HexabitzPlatform/H14R9x-Hardware/README.md

# H14R9x-Hardware
Hexabitz 4 x 5V PWM O/P  + External Supply Module Hardware Design
