HexabitzPlatform/H14R9x-Hardware/Documentation/H14R90.pdf

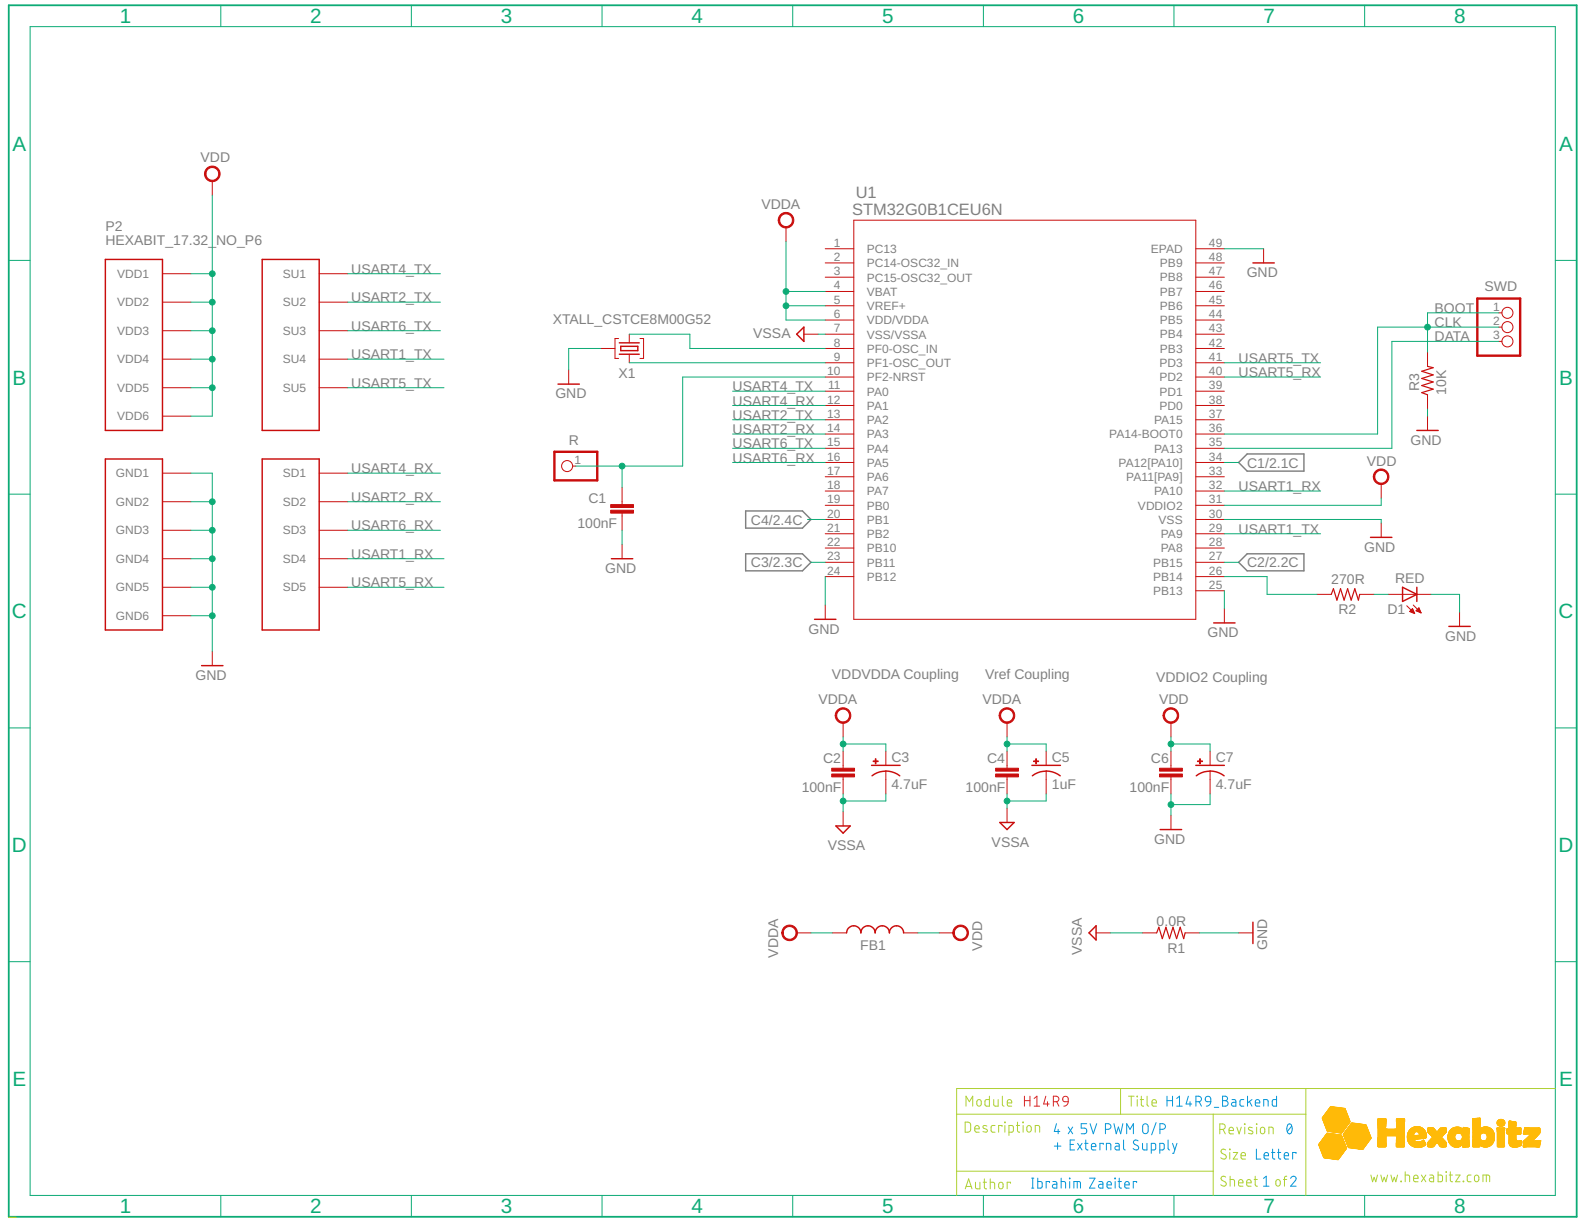
[picture p1: page 1]

5 | 45 PB7
6 | 44 PB6

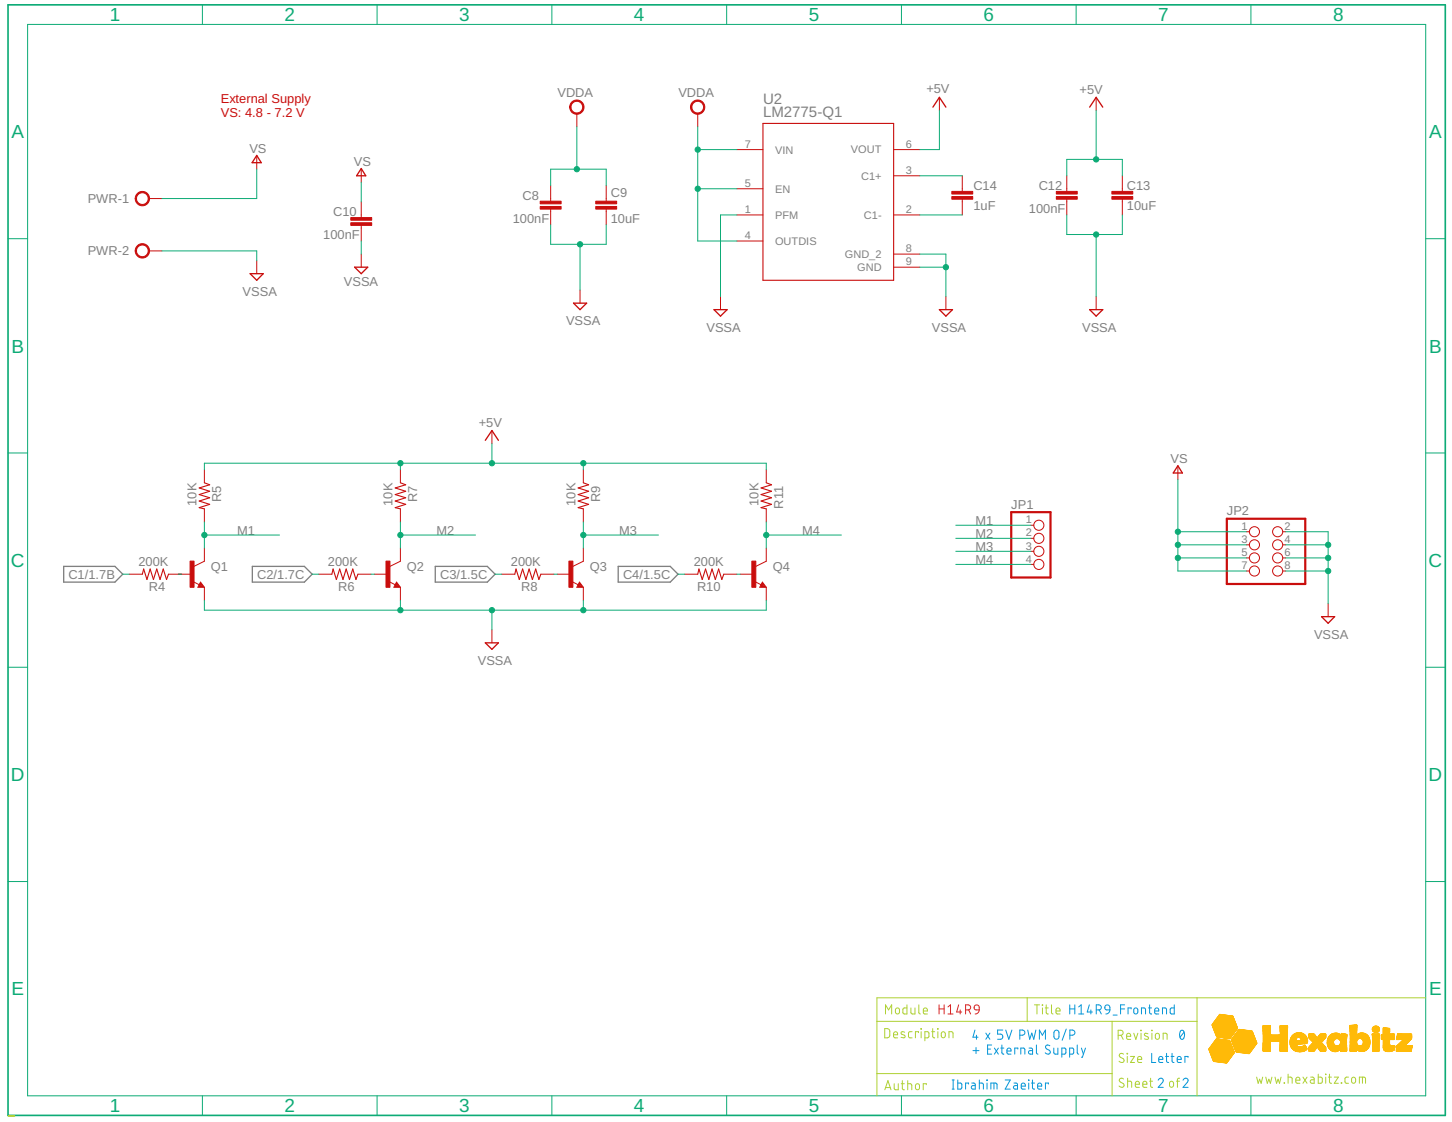
[picture p2: page 2]

3 4
5 6
7 8
