HexabitzPlatform/H14R9x-Hardware/Design/H14R90.brd

## EAGLE design Design/H14R90.brd (2023-11-16)

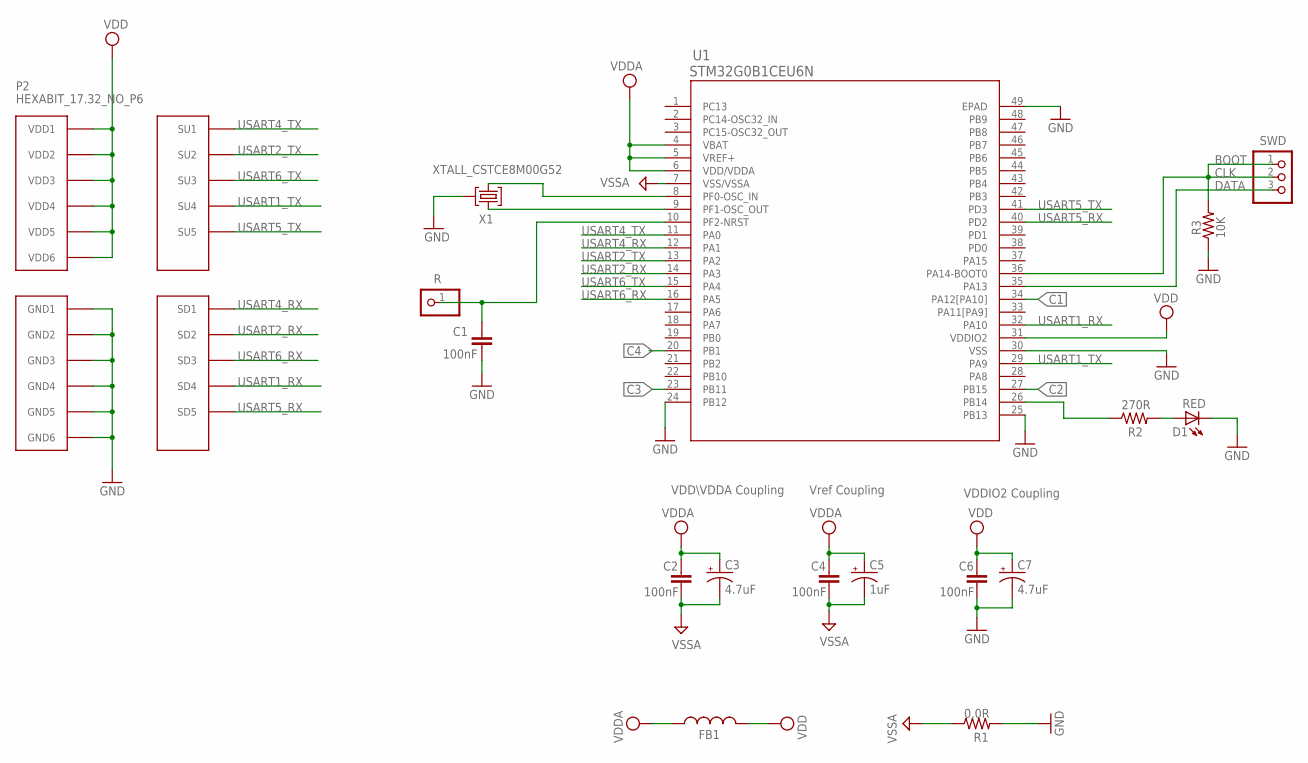
[picture p3: schematic H14R90.sch, sheet 1]

Parts:
C1, C2, C4, C6: 100nF; C-0603
C3, C7: 4.7uF; C-0805-POL
C5: 1uF; C-0805-POL
D1: RED; VLMS1300-GS08; MPN VLMS1300-GS08
FB1: FB-0603
P2: HEXABIT_17.32_NO_P6
R: R; 1X01
R1: 0.0R; R-0603
R2: 270R; R-0603
R3: 10K; R-0603
SWD: PINHD-1X3; 1X03
U1: STM32G0B1CEU6N; HEXABITZ_ICS_QFN_B1CEU6_STM-L
X1: XTALL_CSTCE8M00G52

Connections:
C1: U1.34 (PA12[PA10]); also elsewhere on the board
C2: U1.27 (PB15); also elsewhere on the board
C3: U1.23 (PB11); also elsewhere on the board
C4: U1.20 (PB1); also elsewhere on the board
CLK: R3.2, SWD.1, SWD.2, U1.36 (PA14-BOOT0)
DATA: SWD.3, U1.35 (PA13)
GND: C1.2, C6.2, C7.2 (-), D1.C, P2.PAD_PD7 (GND1), P2.PAD_PD8 (GND2), P2.PAD_PD9 (GND3), P2.PAD_PD10 (GND4), P2.PAD_PD11 (GND5), P2.PAD_PD12 (GND6), R1.2, R3.1, U1.24 (PB12), U1.25 (PB13), U1.30 (VSS), U1.49 (EPAD), X1.P$2 (2)
unnamed: D1.A, R2.2
unnamed: U1.9 (PF1-OSC_OUT), X1.P$1 (1)
unnamed: U1.8 (PF0-OSC_IN), X1.P$3 (3)
unnamed: C1.1, R.1, U1.10 (PF2-NRST)
unnamed: R2.1, U1.26 (PB14)
USART1_RX: P2.PAD_PD4 (SD4), U1.32 (PA10)
USART1_TX: P2.PAD_PU4 (SU4), U1.29 (PA9)
USART2_RX: P2.PAD_PD2 (SD2), U1.14 (PA3)
USART2_TX: P2.PAD_PU2 (SU2), U1.13 (PA2)
USART4_RX: P2.PAD_PD1 (SD1), U1.12 (PA1)
USART4_TX: P2.PAD_PU1 (SU1), U1.11 (PA0)
USART5_RX: P2.PAD_PD5 (SD5), U1.40 (PD2)
USART5_TX: P2.PAD_PU5 (SU5), U1.41 (PD3)
USART6_RX: P2.PAD_PD3 (SD3), U1.16 (PA5)
USART6_TX: P2.PAD_PU3 (SU3), U1.15 (PA4)
VDD: C6.1, C7.1 (+), FB1.2, P2.PAD_PU7 (VDD1), P2.PAD_PU8 (VDD2), P2.PAD_PU9 (VDD3), P2.PAD_PU10 (VDD4), P2.PAD_PU11 (VDD5), P2.PAD_PU12 (VDD6), U1.31 (VDDIO2)
VDDA: C2.1, C3.1 (+), C4.1, C5.1 (+), FB1.1, U1.4 (VBAT), U1.5 (VREF+), U1.6 (VDD/VDDA); also elsewhere on the board
VSSA: C2.2, C3.2 (-), C4.2, C5.2 (-), R1.1, U1.7 (VSS/VSSA); also elsewhere on the board

Notes on the sheet:
Vref Coupling
VDDIO2 Coupling
VDD\VDDA Coupling
BOOT

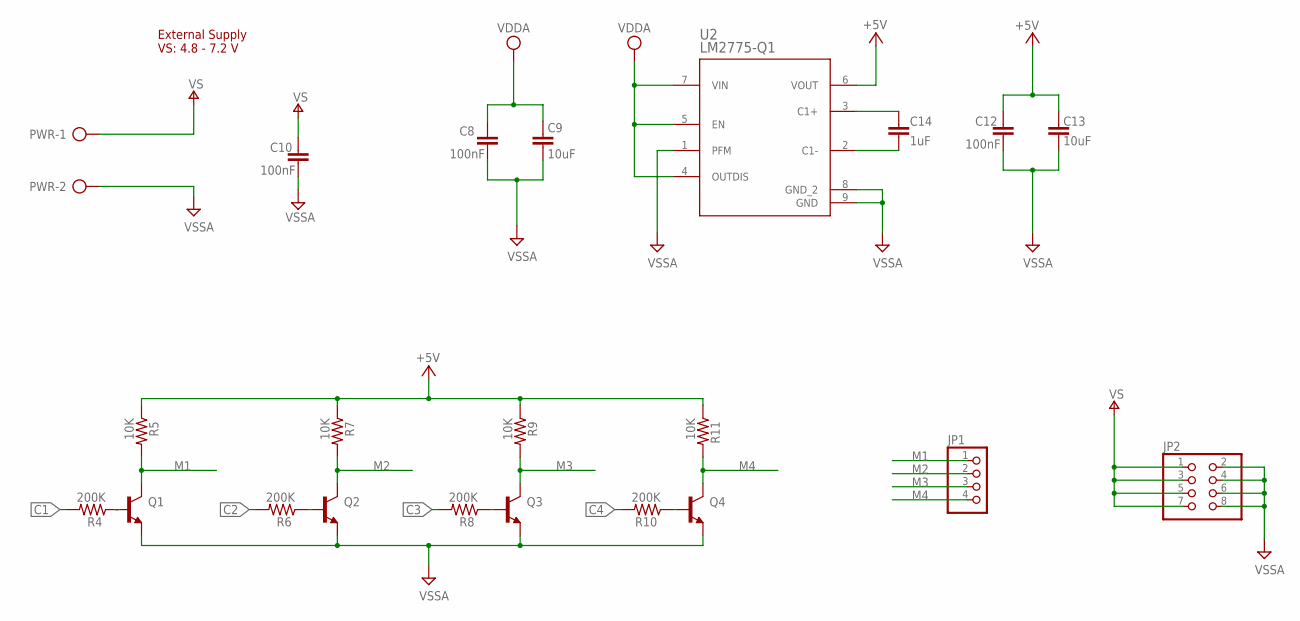
[picture p4: schematic H14R90.sch, sheet 2]

Parts:
C8, C10, C12: 100nF; C-0603
C9, C13: 10uF; C-0603
C14: 1uF; C-0603
JP1: PINHD-1X4; 1X04
JP2: PINHD-2X4; 2X04
PWR: AK500/2
Q1, Q2, Q3, Q4: MMBT3904LT1
R4, R6, R8, R10: 200K; R-0603
R5, R7, R9, R11: 10K; R-0603
U2: LM2775-Q1; DSG0008A

Connections:
+5V: C12.1, C13.1, R5.1, R7.1, R9.1, R11.1, U2.6 (VOUT)
C1: R4.2; also elsewhere on the board
C2: R6.2; also elsewhere on the board
C3: R8.2; also elsewhere on the board
C4: R10.2; also elsewhere on the board
M1: JP1.1, Q1.3 (C), R5.2
M2: JP1.2, Q2.3 (C), R7.2
M3: JP1.3, Q3.3 (C), R9.2
M4: JP1.4, Q4.3 (C), R11.2
unnamed: C14.2, U2.2 (C1-)
unnamed: C14.1, U2.3 (C1+)
unnamed: Q1.1 (B), R4.1
unnamed: Q2.1 (B), R6.1
unnamed: Q3.1 (B), R8.1
unnamed: Q4.1 (B), R10.1
V+: C10.1, JP2.1, JP2.3, JP2.5, JP2.7, PWR.1
VDDA: C8.1, C9.1, U2.4 (OUTDIS), U2.5 (EN), U2.7 (VIN); also elsewhere on the board
VSSA: C8.2, C9.2, C10.2, C12.2, C13.2, JP2.2, JP2.4, JP2.6, JP2.8, PWR.2, Q1.2 (E), Q2.2 (E), Q3.2 (E), Q4.2 (E), U2.1 (PFM), U2.8 (GND_2), U2.9 (GND); also elsewhere on the board

Notes on the sheet:
External Supply VS: 4.8 - 7.2 V

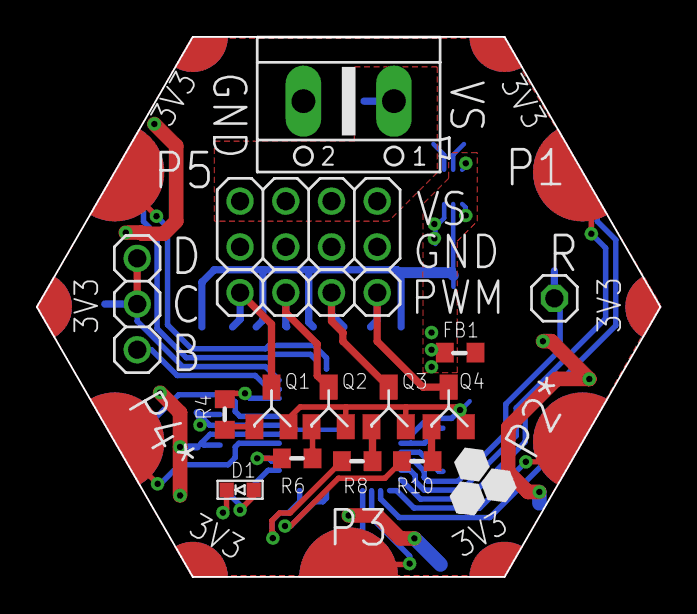
[picture p5: board H14R90.brd from above]

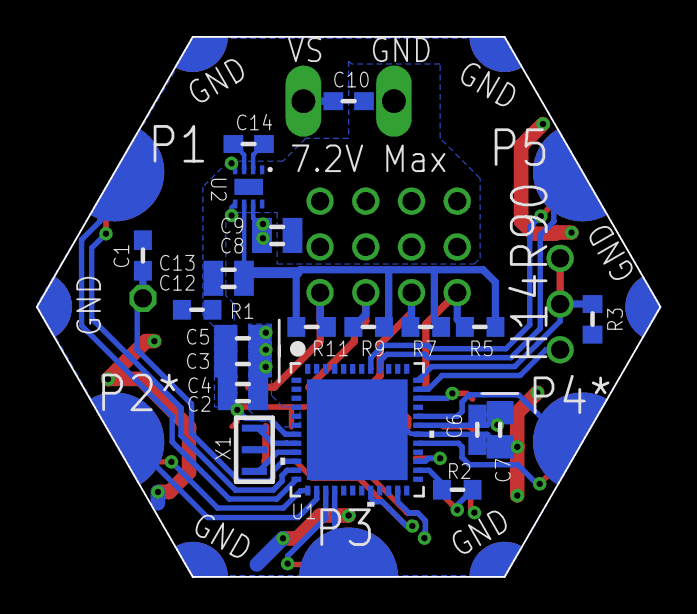
[picture p6: board H14R90.brd from below]

Board: 2 copper layers, 34.6 x 30.0 mm, 39 parts (23 on the bottom side), 37 nets.
