HexabitzPlatform/H14R9x-Hardware/(commit log)

2023-09-16 - First Version
    [H14R90.brd, H14R90.sch, H14R90.xlsx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]
2023-11-16 -Fix the outputs pin headers spacing
    [H14R90.brd, H14R90.xlsx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]
2023-11-16 -Correcting some documentaion issues
    [H14R90.brd, H14R90.sch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]
